TonyCooT/water_research_module/.image/stand.jpg

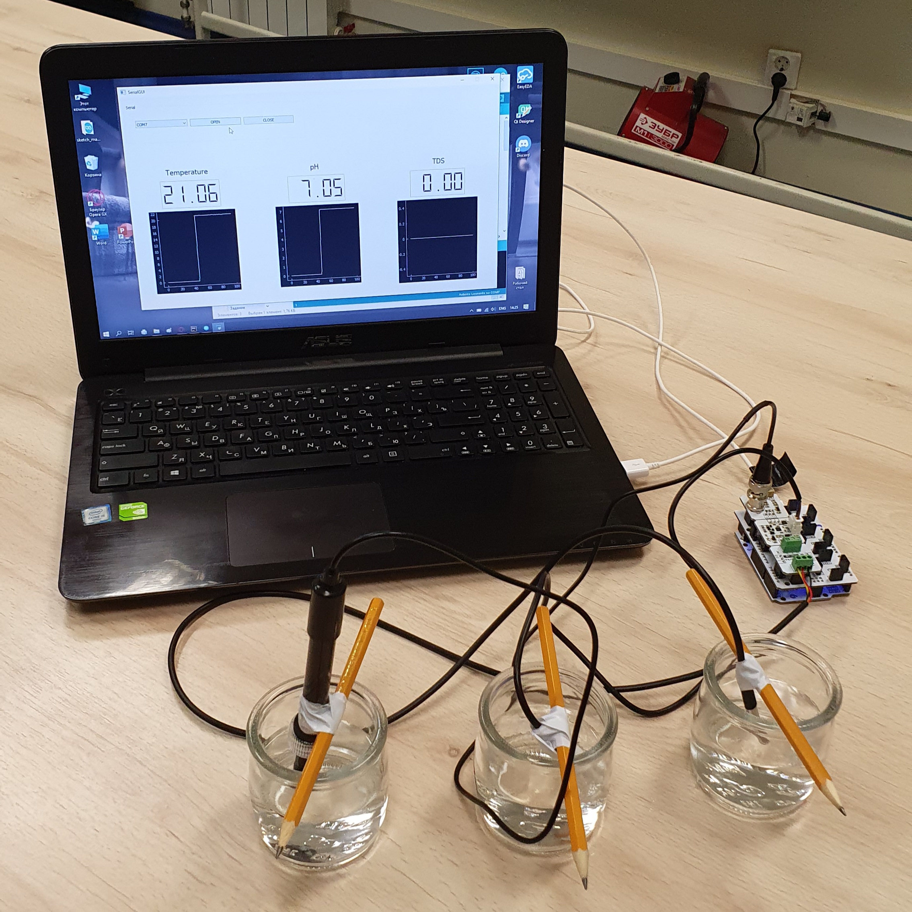
.image/stand.jpg
