TonyCooT/water_research_module/practice/task/instruction/flow_cell_design.pdf

Задание. Проектирование проточной ячейки

Инструментарий:

− САПР Компас-3D Учебная версия.

Необходимо ознакомиться с чертежом проточной ячейки, спроектированной для

использования совместно с датчиком RMD-ISDC205 ф. Remond (см. Приложение к заданию).

Знакомство включает понимание предназначения элементов чертежа и указанных на нем

обозначений. Руководствуясь чертежом, требуется создать трехмерную модель проточной

ячейки. Резьбу различного вида рекомендуется изобразить условной.

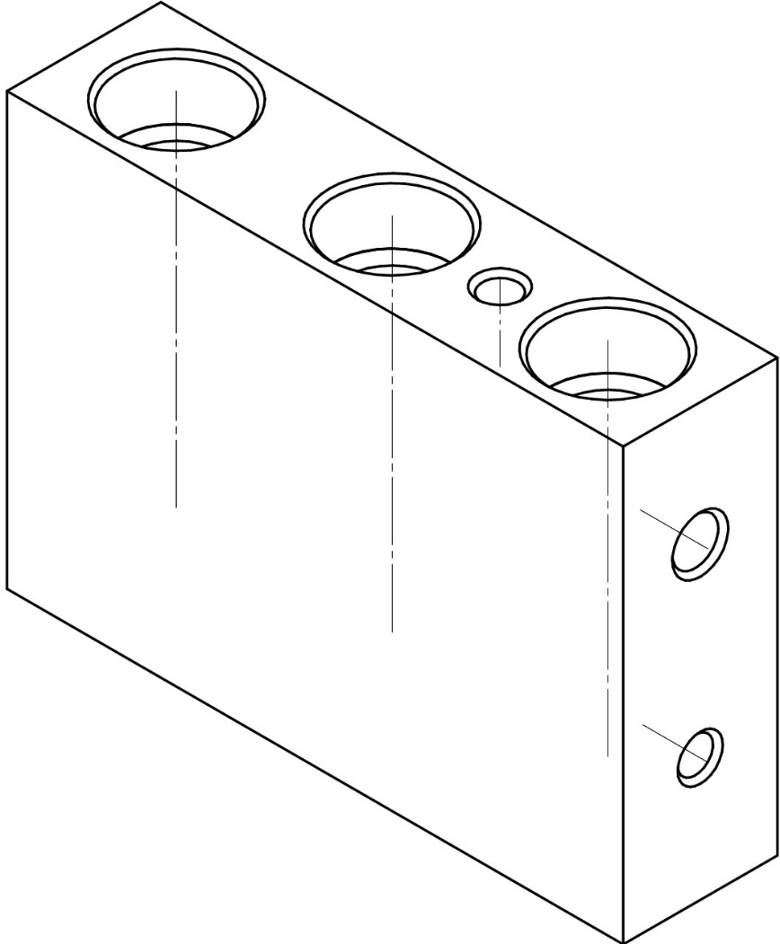
[picture p2: figure]
