TonyCooT/water_research_module/.image/flow_cell.jpg

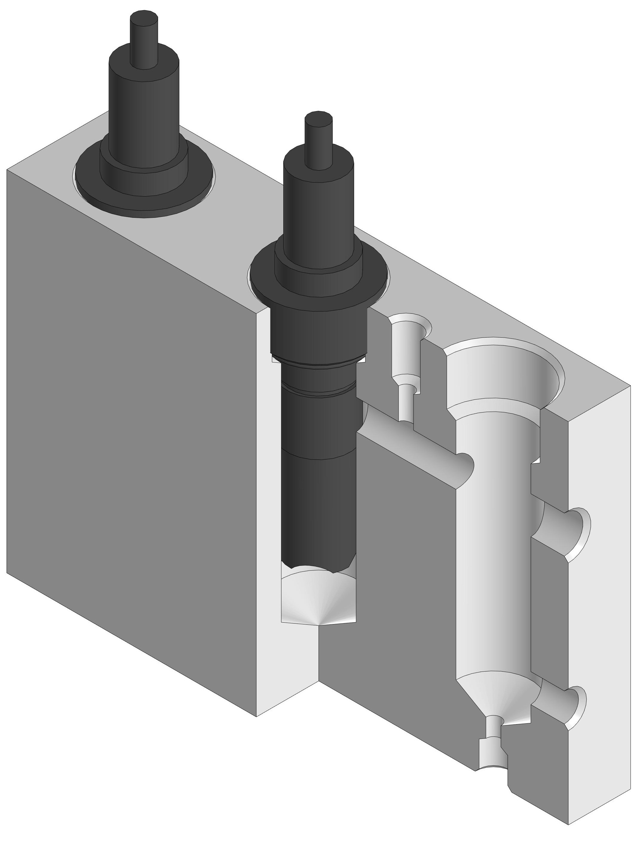
.image/flow_cell.jpg
