TonyCooT/water_research_module/.image/gui.jpg

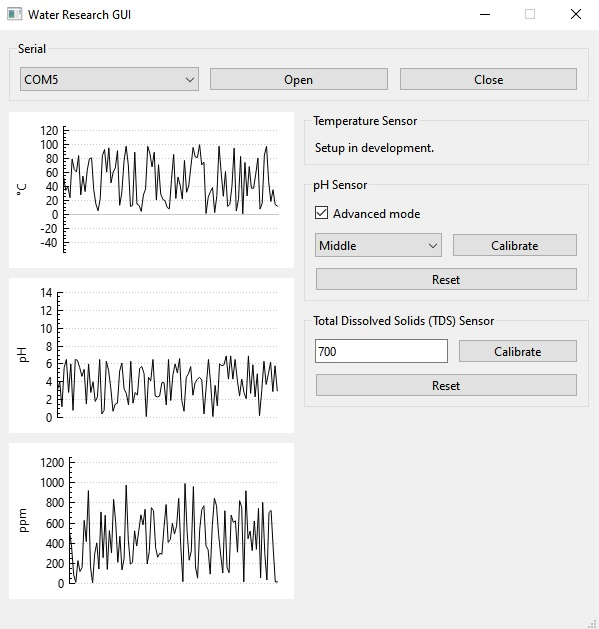
.image/gui.jpg
