TonyCooT/water_research_module/.image/pcb.jpg

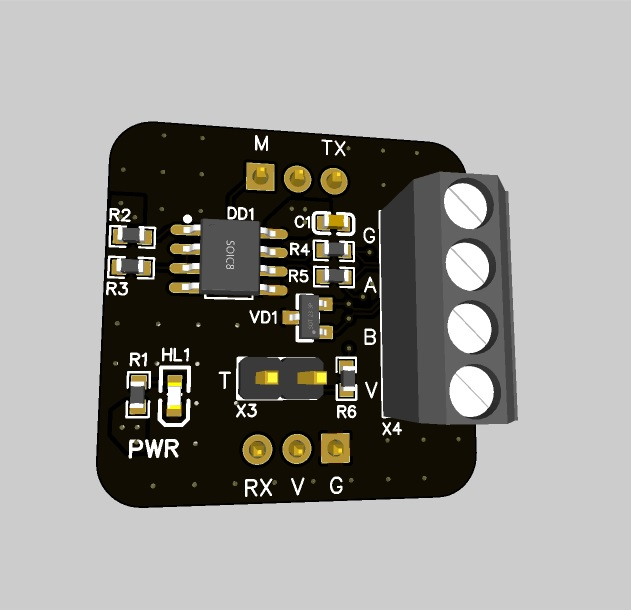
.image/pcb.jpg
