TonyCooT/water_research_module/.image/scheme.jpg

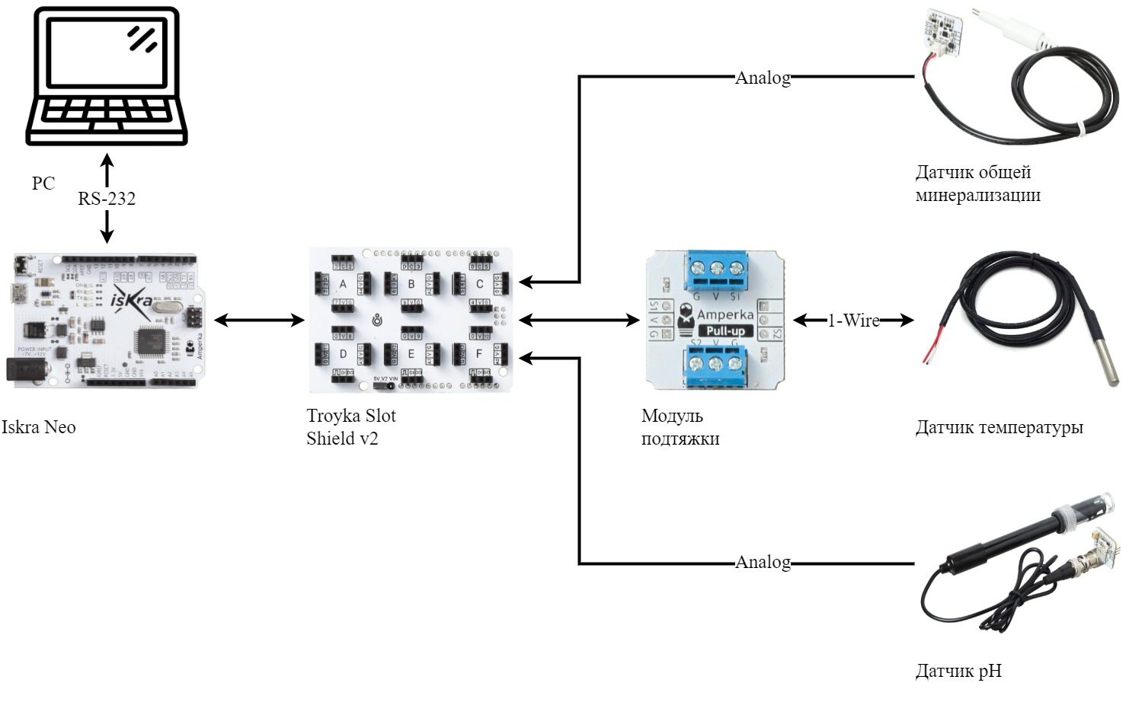
.image/scheme.jpg
