TonyCooT/water_research_module/useful/components.pdf

Материально-технические компоненты

### В материалах проекта подразумевается использование компонентов, представленных в

### таблице ниже. Отдельные компоненты могут быть заменены на аналогичные без ущерба для

### использования или на усовершенствованные с дополнительной проработкой особенностей их

применения.

№ | Компонент | Цена, руб. (31.01.2023) | Ссылка
1 | Iskra Neo | 1340 | https://amperka.ru/product/iskra-neo
2 | Troyka Slot Shield v2 | 730 | https://amperka.ru/product/arduino-troyka-slot-shield
3 | Модуль подтяжки | 220 | https://amperka.ru/product/troyka-pull-up
4 | Кабель USB A – Micro USB | 340 | https://amperka.ru/product/usb-cable-micro
5 | Герметичный датчик температуры DS18B20 | 330 | https://amperka.ru/product/sealed-temperature-sensor-ds18b20 (https://amperka.ru/product/sealed-temperature-sensor-ds18b20)
6 | pH-метр для воды | 2700 | https://amperka.ru/product/troyka-ph-sensor
7 | TDS-метр для воды | 2230 | https://amperka.ru/product/troyka-tds-sensor
8 | Стакан высокий градуированный, 400 мл | 235 | https://formula-re.ru/katalog/laboratornaya-posuda/stakan-vysokij-graduirovannyj (https://formula-re.ru/katalog/laboratornaya-posuda/stakan-vysokij-graduirovannyj)
9 | Дистиллированная вода, 1 л | 51 | https://www.maxidom.ru/catalog/distillirovannaya-voda-elektrolit/1000959541/ (https://www.maxidom.ru/catalog/distillirovannaya-voda-elektrolit/1000959541/)
Итого | | 8176
