TonyCooT/water_research_module/practice/solution/rs_485_transceiver/schematic.pdf

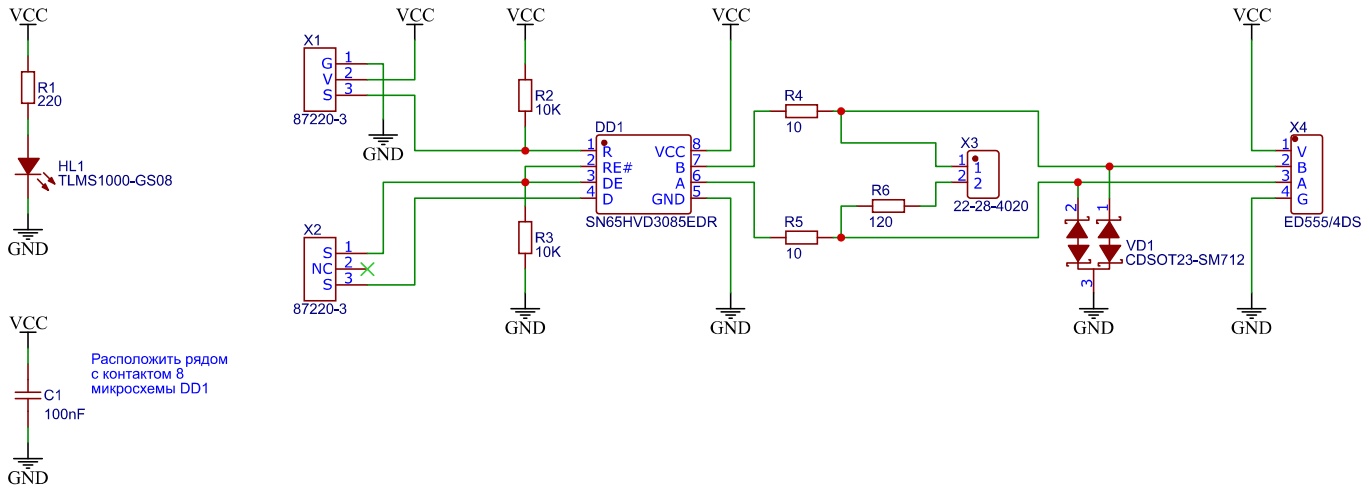
[picture p7: page 1]
