TonyCooT/water_research_module/practice/task/support_material/flow_cell_design/drawing.pdf

А-А

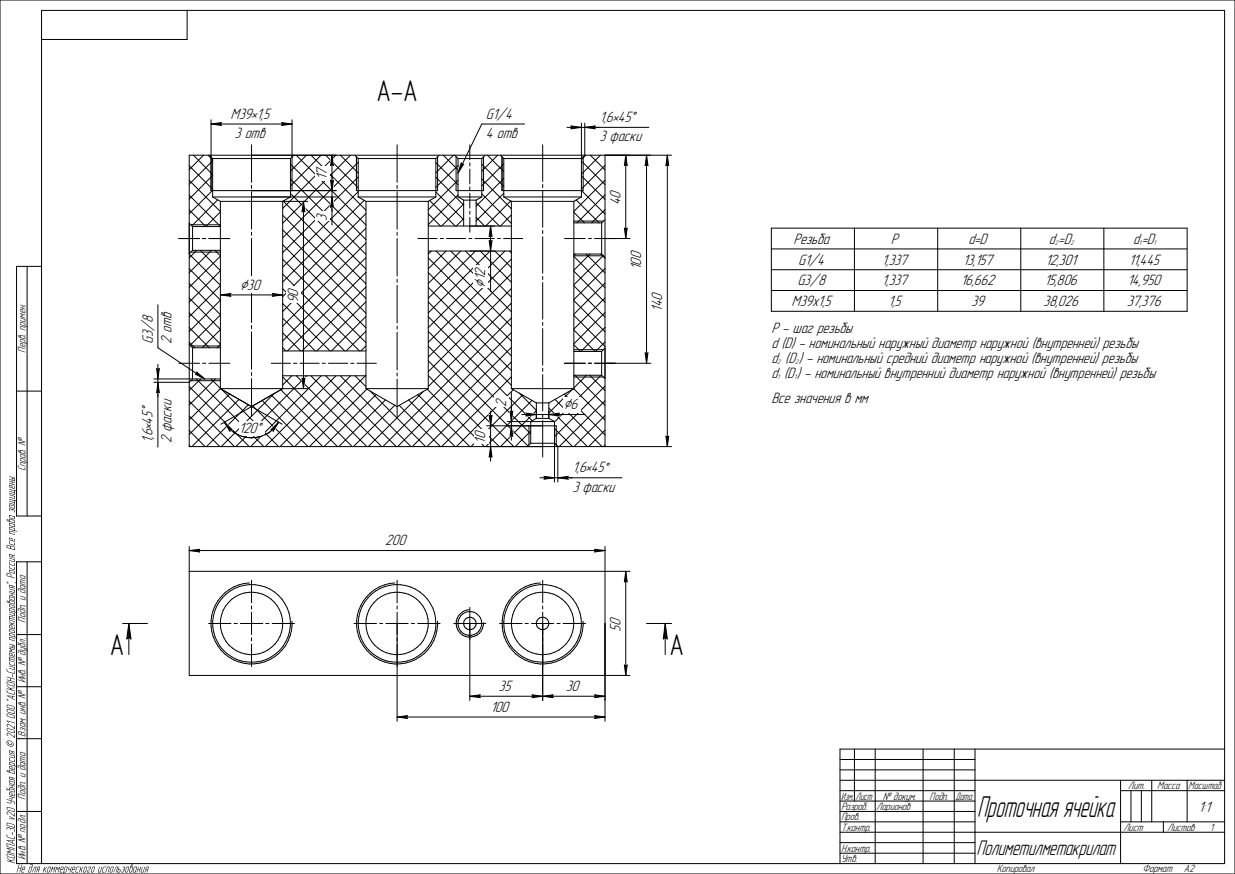
[picture p8: page 1]
M39•1,5 3 отв; 4 отв; 120 G3/⁸ 2 отв; 1,6•45 3 фаски; 1,6•45 3 фаски ¹,6•45; 2 фаски; Ларионов; Проточная ячейка Инв. № подл. Подп. и дата Взам. инв. № Инв. № дубл. Подп. и дата; Полиметилметакрилат Справ. № Перв. примен.; Копировал; Формат A2

Резьба | 1,337 P | d=D

P - шаг резьбы
d (D) - номинальный наружный диаметр наружной (внутренней) резьбы d2 (D2) - номинальный средний диаметр наружной (внутренней) резьбы d1 (D1) - номинальный внутренний диаметр наружной (внутренней) резьбы

Все значения в мм

Лит. | Масса | Масштаб

Изм. Лист | № докум. | Подп. | Дата | | | | | 1:1 1
Разраб.
Пров.
Т.контр. | | | | Лист | Листов
Н.контр.
Утв.
