TonyCooT/water_research_module/practice/task/instruction/sensor_model.pdf

Задание. Создание трехмерной модели датчика

Инструментарий:

− САПР Компас-3D Учебная версия.

Необходимо создать трехмерную модель датчика RMD-ISDC205 ф. Remond, внешний

вид и размеры которого представлены на рисунке ниже. Неуказанные размеры выбираются на

усмотрение исполнителя с точки зрения их непротиворечивости. Метрическую резьбу

рекомендуется изобразить условной. Модель датчика планируется использовать в

дальнейшем при проектировании проточной ячейки.

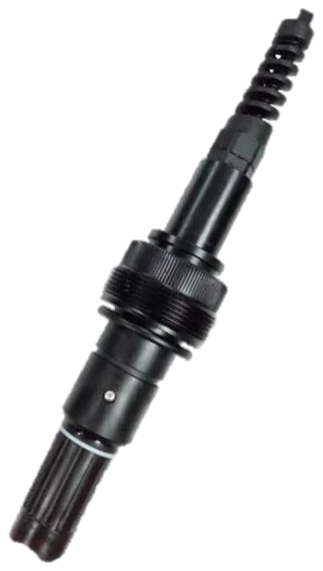
[picture p10: figure]
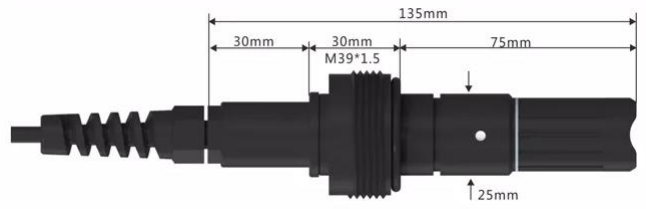
[picture p11: figure]
