TonyCooT/water_research_module/(commit log)

2022-09-30 Добавил файлы программного обеспечения
2022-10-07 Добавил приложение
    - Внес правки в файлы программного обеспечения
2024-11-24 Обновил структуру файлов
